gwoolger/Audio-Macro-Pad/BOM.csv

Item | Qty | Supplier | Cost/item | Total Cost | link
Keyboard Switches | 1 | AliExpress | $9.06 | $9.06 | https://www.aliexpress.com/item/1005006376024657.html?mp=1
Keycaps | 2 | AliExpress | $4.22 | $8.44 | https://www.aliexpress.com/item/1005009364428646.html?mp=1
2pcs encoder knobs | 2 | AliExpress | $3.42 | $6.84 | https://www.aliexpress.com/item/1005006063377230.html?mp=1
5pcs ec11 | 1 | AliExpress | $2.83 | $2.83 | https://www.aliexpress.com/item/10000056483250.html?mp=1
Screen | 3 | AliExpress | $1.84 | $5.52 | https://www.aliexpress.com/item/32709141534.html?mp=1
Glue gun | 1 | AliExpress | $13.39 | $13.39 | https://www.aliexpress.com/item/1005010440447447.html?mp=1
3pcs rp2040 zero | 1 | AliExpress | $8.03 | $8.03 | https://www.aliexpress.com/item/1005012511141182.html?mp=1
Speaker | 1 | AliExpress | $8.77 | $8.77 | https://www.aliexpress.com/item/1005006807962595.html?mp=1
UK plug | 1 | AliExpress | $4.38 | $4.38 | https://www.aliexpress.com/item/1005006808365132.html?mp=1
5pcs PCB | 1 | JLCPCB | $4.00 | $4.00 | https://jlcpcb.com
Case | 2 | JLC3DP | $8.53 | $17.06 | https://jlc3dp.com
Estimated total shipping | 1 |  |  | $10.00
