gwoolger/Audio-Macro-Pad/hardware/Case.step

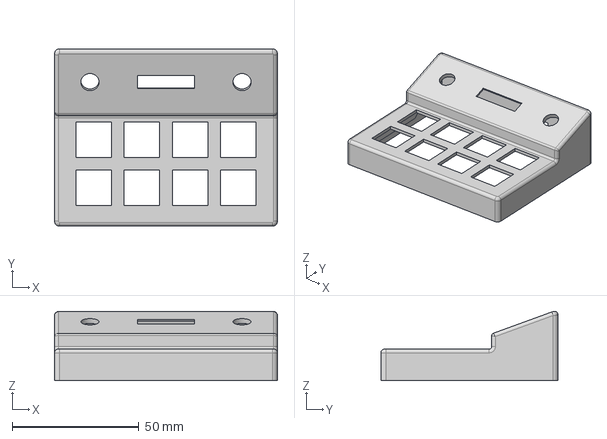
[picture p4: CAD file, 2026-10-20]
hardware/Case.step
88.0 x 70.0 x 27.4 mm
