gwoolger/Audio-Macro-Pad/(list of files, cad)

Other CAD files:
hardware/Audio Macro Pad.f3z
