gwoolger/Audio-Macro-Pad/(list of files, drawings)

Other design files:
hardware/PCB_Design.json
