gwoolger/Audio-Macro-Pad/JOURNAL.md

# Sound Pad – devlog

<!-- Generated by Half Life from project cmvf4hkoq0au201rcfbvv20zj. Edits here are overwritten on the next sync. -->
<!-- Generated: 2026-10-22T06:30:53.644Z -->

> [!NOTE]
> This devlog is mirrored from [Half Life](https://halflife.hackclub.com) – [open the project](https://halflife.hackclub.com/projects/cmvf4hkoq0au201rcfbvv20zj). Editing it here will not change the platform's copy, and the next sync overwrites this file.

> Audio Pad with rotary encoders and buttons, similar to a synth. Also stylistically akin to a macro pad

| Week | Tier | Hours logged | Entries |
| --- | --- | --- | --- |
| Week 3 | Tier 3 | 30.2h | 5 |

## Contents

1. [2026-10-19 – # Made the Schematic](#2026-10-19-made-the-schematic)
2. [2026-10-19 – # Routed the board](#2026-10-19-routed-the-board)
3. [2026-10-20 – # Started the case, and changed the PCB](#2026-10-20-started-the-case-and-changed-the-pcb)
4. [2026-10-20 – # Finished the Case](#2026-10-20-finished-the-case)
5. [2026-10-22 – # Finished the Project](#2026-10-22-finished-the-project)

## Design

### 2026-10-19 – # Made the Schematic

**6.1h**

# Made the Schematic

## Wanted to make a speaker
Was researching what I could make for quite a while, as I was looking into making some sort of sound system, as the speakers themselves seemed a reasonable price for a decent quality.



But the problem was, from my research, I found that speakers are highly dependent on their cases for sound, and without a 3D printer, not much I could do for that, as I can only order things. So annoyingly I had to scrap those 2 hours, and put the time into something else.

## Came up with current idea
So for my tech GCSE, we're going along the idea of multi use tech. So I was thinking to make a Sound Pad, which can function as an instrument, but also possibly behave as a synth/macro pad style thing.
So I researched a bit for the BOM for that, to see if it would be feasible, and I think it will be - and I'm planning to still add a speaker from me research from before - it would likely just be cheaper and not sound half as good.



Also I was originally planning to go with an ESP32, as I'm fairly experienced in using them, but looking at it, raspberry pi boards have much better community support, especially for this kind of thing, so I decided to give an rp2040 zero a go. I hope this doesn't come back to bite me in the build week when I do the code for it lol.



 I also had the problem for what parts to use, as there are many different types of parts..Take keyboard switches for example, there are loads of them, at varying price points, which theoretically all work. I decided to go with the outemu red keyboard switches as they seemed decent, and quite cheap.

But then there's also other decisions like keycaps etc, so I basically went for the most average looking ones I could.



The other thing that was time consuming, as when I looked for rotary encoders originally, there were loads of options - smooth, detents, push button etc, but we're all really expensive. So after researching a lot, I found you can get rotary encoders called ec11's which can be found cheaply and have the appropriate functions.



## Made the Schematic

So first off, I wasn't planning to make a custom PCB, but it seems you need one for keyboard switches, so I gave in - but it took way longer than I would have liked.

So I'd assumed making the schematic would be simple - as whilst I only learnt how to make them two weeks ago, they seem fairly simple, at least for this little components. And it was, except finding a MX switch symbol and footprint I was happy with was an absolute pain.



So you'd think that something that simple there would be plenty of community contributed designs (I'm working in EasyEDA) - but that was the problem. There were too many designs essentially flooding it with symbols - most of them had no footprint associated.

But in the end, I managed to scrape together the start of a schematic:



And after that, I thought it looked a bit simple, so I decided to add some other things - namely two rotary encoders and a screen - and I've attached them on headers, so I can angle them in the case instead of having them on the PCB.



## Next steps
- Layout and route the PCB
- Probably make a case. will see how I'm doing time wise.

## tl;Dr
Spent too long researching parts and compatibility - was probably worth it though. And created the Schematic for the board

### 2026-10-19 – # Routed the board

**5.3h**

# Routed the board

So I finished the schematic earlier today (I've got loads of time, as no school this week), and now I'm thinking of manually routing the PCB. I don't know how hard it is, but I think it will be a fun thing to do.

So I opened it, then had the problem of how to lay out the keyboard switches.



The problem is, keyboard switches are all the same size, but the keycaps are different. So I did a bit of research, and found the distance you're meant to put us 19.05. idk why it's .05, but I did it anyway. And the other problem I had was how many switches to use, and how I wanted to lay them out. Especially in relation to the MCU. But eventually I decided to go with a 2 row of 4 keys design, with the rotary encoders and screen above the MCU.



And as I'm planning on not putting those on the PCB, as I plan to make a custom case which should mount those at an angle, I had to add the layouts for the pin headers spaces which I can solder them to.



That was my first design, but then I thought of a better positioning. All this was a pain to do, as I had to make sure everything was in line with the keyboard which is in a stupid 19.05 spacing.



## Finally got to routing

Manually routed things, with the intention of using dual ground pours. I think I only used 2 vias in the end. Was half considering adding support for another MCU at some point, by adding another set of pin headers to the board, but decided against it.



And with the silkscreen and ground pour:



So, it was as easy as that - only took a full day to do (well kinda did start the first journals research yesterday as I had some ideas)

So I rendered the board out, and downloaded the Gerber and looked at the initial expected price





another photo (or 2) as it looks sick:





### 2026-10-20 – # Started the case, and changed the PCB

**5.9h**

# Started the case, and changed the PCB

So I was bored last night, and decided to 3d model a case, as I'd finished the PCB all on the first day of the week.

So I exported the PCB SVG from Easyeda, to import into Fusion



This just gave me an "accurate" reference that I could model off.

So, I started modelling, parametrically of course, and then I found out that the svg I imported was the wrong dimensions. That was annoying.





And as you can't change a sketch to reimport an SVG, I had to start again from scratch. Which took too long. And I also only found out it was the wrong size when I was making the spacing for the keyboard switches - quite far in to making the case.

Realised I had a better photo of the problem:



But I did get it sorted in the end.

I also then had the problem of deciding how thick to make the walls. As for a keyboard switch panel, from my research, the average thickness is 1.5mm. Which to me seemed too thin for a 3d print. So I made a design, which went to 1.5mm where the switches snapped in, but then tapered thicker in the middle.

And I also spent a good while figuring out how I wanted to make the case. As in how many seperate pieces I would need. I knew I needed one for the switch panel, but I wanted to see if I could get away with just having that. so I made a lip on the inside which the PCB could get pushed up into, and then added some holes for threaded inserts which I can then use to screw the PCB in place. I also only added these to the back, as the switches should hold it up at the front, and I also dont have the space without making the case huge - it's currently only about a cm thick, and I think is like 10x8cm. So probably too compact.

If I do it again, will make it less compact, so I could both design it, and later on, build and assemble it quicker.

Then, I found out you can export a 3d model from Easyeda. So I exported it the switches and the rp2040, and realised I had a few problems.

First of all, I couldn't make the panel any thicker, but also, the rp2040 zero would hit the top panel



So firstly, I just decided to make the panel 1.5mm thick, which meant I'd have to get it printed out of some strong, but expensive material. From research mabye metal or something.

And I also decided that instead of rewiring the board, I'll just surface mount the rp2040. So I looked into doing that, then realised I had a few vias under the board. Had to get rid of those, otherwise they might cause problems.

So I rewired the board by hand, making sure there were no vias underneath the board



Then it was rather late, so I decided to come back to it the day after (will most likely get it done today - benefits of being on holiday - except I won't be at my computer for the last half of the week).

## tl:dr

SVG's in Fusion 360 can have the wrong scale. And are a pain to resize. Had to remodel the case for that. Part tolerances and clearances also are important. had to reroute the board for that.

### 2026-10-20 – # Finished the Case

**7.4h**

# Finished the Case

Spent a while experimenting with different sole heights, and positionings, with no raised lip etc, slope angle as well. Finally decided to have it raised up by 6mm to allow for the keys, then had the slope go at a 20 degree angle in the end. possibly too shallow, but we'll have to see.

That's one version:



This is the latest one:



So after that, I realised that I gave myself very little space to work with, in that I had no clue how I'd arranged things inside the case. So I decided to make a reference model of the screen.

This was a slight pain as the 0.91 oled I went for, is commonly confused with the 0.96 oled, and the datasheets had different values.



So I did model one off these dimensions, and it looked alright, except it was sort of meh. Like I wasn't quite sure if all the dimensions were quite right etc. So in the end, I just spent another half an hour looking for designs on the internet. And in the end, I found this really good site called Grab cad, which I got a step model off, so I'm hoping that's accurate enough.



Then I figured out the actual screen size within the black bit, centered it in the slope - I hope this is right, instead of shifted up or down - then made a cutout for it, and a relief for the PCB. This became a problem later though.



Originally I was planning to make reference models for the encoders as well, but I decided just to run with it, and check measurements by hand (probably a bad idea). So I had to go back to AliExpress to look for knobs, and ended up with these:



It was all a surprising pain to do, as when looking up the metal knobs I wanted, I got a lot of expensive ones, a lot of too large ones, and a lot of guitar knobs.

But anyway, so I placed the holes centered horizontally on the slopes bit, then guessed a position for the centers until they looked good. A highly scientific way might I add.

That got me this:



So I uploaded it to jlc3dp, and got a warning. In my intelligence, I made the relief for the screen a whole 0.2mm thick. Not really sure how I managed this, but meant I had to go back and change things.

So it's now 0.75mm thick at it's thinnest point, and whilst I was at it, I spent way too long beefing the rest of the sides up to at least 1.5mm - visible in the section analysis below:



And with that, I was done. Well aside from adding mounting hardware, power cutouts etc - all thing that seems small but took a fair bit of time - especially the usbc port on the rp2040. Who knows you need to make them square for some clunky cables?

But anyway, I got around to ordering for the second time, and this time there was only a yellow warning for thinness. Hopefully it will be fine.



 Oh and I also decided to get it made out of MJF nylon. As from research it is meant to be really strong and durable.

## Other notes
Just for the record, I thought of this before the starter project was announced, although they are quite similar. However because of the starter project, I'm not going to include a speaker built in, but will probably get one to connect to it, as somehow, I don't actually have any speakers (literally just got my phone and earbuds).

Oh and I'm also planning to make 2 of these. One for each hand.

## tl;dr
Spent way too long messing with slop positioning and angles, as well as reference pieces. Eventually got it finished, and it's looking pretty good



## To Do
I think now it's just finished the BOM, and add it to half life.
Oh and I need to sort out the GitHub repo as well.

### 2026-10-22 – # Finished the Project

**5.5h**

# Finished the Project

## Finished the BOM

So I finished the CAD yesterday, or might have been the day before



### Changed the Parts

I decided to change from the outemu switches to gateron ones, as from research they're meant to be much better.





Also spent a lot of time looking around and seeing if I could find cheaper things. In some cases I could, but idk about the reliability one AliExpress, so I generally went with ones that had more sales.

I actually spent way too long just looking at different pricing options.

### Found problems

I realised that when I modelled the CAd for the rotary encoders, whilst I made a hole for them, I didn't make anything to stop them from turning in the socket.



So as I don't have enough time to remodel the CAD, and as I'm not sure how I would, as the EC11's have different base measurements, I'm planning just to glue them in. So I've picked up a glue gun for that - Couldn't find one in the shop, and can't buy one myself, so have just put it in the BOM. Oh, and if I tried to model it into the case and got it wrong, then it would be more costly than this, so this is a cheaper way.

Also realised that it's meant to be a sound week, and mine will only output midi signals, not actual sound. But I did find out you can get some speakers for fairly cheap



So I'll be figuring out how to wire them all up in the build week.

### Current total



Shows as ~$64 here for aliexpress, but when I go to buy it later, it will invariably be much more expensive, as the deals won't work out etc - can be seen in the BOM, as parts will lose the new shopper discount when I buy stuff for the first week. In the actual BOM it totals to $71.26, which is a more likely price.



But with the JL3DP price of $17 + $10 shipping, it gets close to the $100 anyway. But still under.

Also from my understanding the BOM.csv total is the total budget I have to buy things, so with coupons it should mean that it should be a bit cheaper. But anyway, with everything at its full price it's still under.

## Extras

Oh and my plans for the speaker, is to get one with a battery, and basically just hijack it. so it should be able to work without being plugged in (think I've got some buck/boost converters around). Also when I made the PCB, I made sure to expose the extra pins, so I have 4 analogue to digital pins that I can use.

## tl;dr

Finished the BOM, but changed some parts.
