gwoolger/Audio-Macro-Pad/code/main.cpp

// Just the barebones skeleton definition before I finish the code in build week
// Or might just use QMK or VIAL etc.

#include <Arduino.h>

// Switches K1-K8
#define SW1 0
#define SW2 1
#define SW3 2
#define SW4 3
#define SW5 4
#define SW6 5
#define SW7 6
#define SW8 7

// I2C Screen K9
#define SDA_PIN 8
#define SCL_PIN 9

// Encoders K10, K11
#define ENC1_A 10
#define ENC1_B 11
#define ENC2_A 12
#define ENC2_B 13

// Encoder buttons
#define BTN1 14
#define BTN2 15

// Spare pins J1
#define SPARE1 26
#define SPARE2 27
#define SPARE3 28
#define SPARE4 29

void setup() {
    // initial code, so just startup

void loop() {
    // keypress checks
}
