gwoolger/Audio-Macro-Pad/(commit log)

2026-10-19 Sync Sound Pad from Half Life
    [BOM.csv]
2026-10-19 Added PCB to readme
2026-10-19 Added PCB files
    [PCB_Design.json, Schematic.sch]
2026-10-20 Added Case stuff
    [Audio Macro Pad.f3z, Case.step]
2026-10-22 Added BOM table to readme
2026-10-22 Fixed Readme bom twble
